enspectr/bar-scan-bt/README.md

# BT adapter for GM67 bar code scanner
Its using ESP32 to implement BLE virtual keyboard for communicating with the host.

This document describes firmware version 1.1.

## Wiring

The following figure shows connections to ESP32C3Zero module used as a controller.

<p align="center">
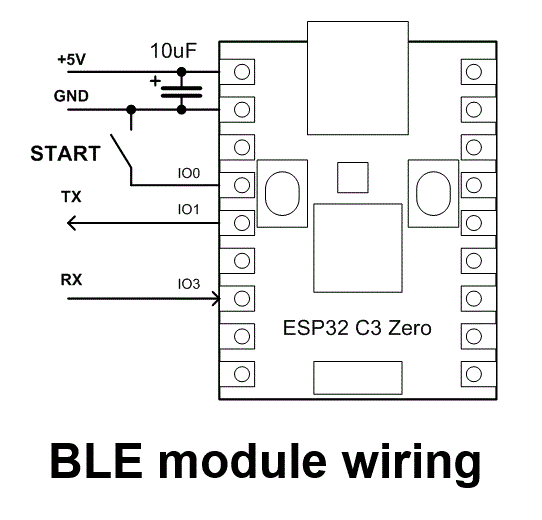
[picture p1: doc/wiring.gif]
  
</p>

## Building

Use Arduino to compile and flash https://github.com/enspectr/bar-scan-bt/blob/main/BarScanBLE/BarScanBLE.ino
To be able to build this code add the following to Arduino Additional board manager URLs:
```
https://raw.githubusercontent.com/espressif/arduino-esp32/gh-pages/package_esp32_index.json
```
Then go to Boards Manager and install **esp32 by Espressif Systems**. The code is tested with version 3.0.7.
Before building the adapter the following libraries should be installed:
1. The NimBLE stack https://github.com/h2zero/NimBLE-Arduino. The simplest way to do it is by using Arduino libraries manager.
2. The virtual keyboard library https://github.com/enspectr/ESP32-BLE-Keyboard. One can either check it out from github to the Arduino libraries folder or download it as [zip-file](https://github.com/enspectr/ESP32-BLE-Keyboard/archive/refs/heads/master.zip) and add it to the project by using menu *Sketch/Include Library/Add .ZIP Library...*
3. Adafruit NeoPixel library (available via Arduino libraries manager).

The following build options are recommended:
* Board: ESP32C3 Dev Module
* USB CDC On Boot: Disabled
* CPU Frequency: 80MHz

## Initial configuration steps

The scanner module factory configuration is continuous scan emulating USB keyboard. So it will not work with ESP32
controller out of the box. There are two control codes that should be scanned once to properly configure GM67 module.

<p align="center">
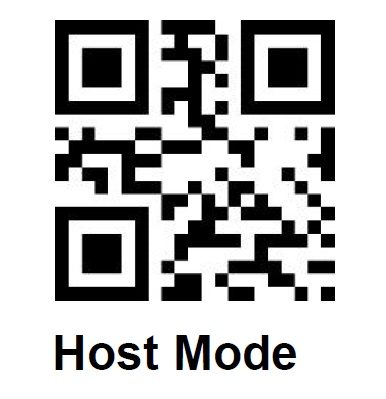
[picture p2: doc/host_mode.jpg]
  
</p>

After switching to host mode the scanner stops continuous scan. Use button on the GM67 module board to scan the following code.

<p align="center">
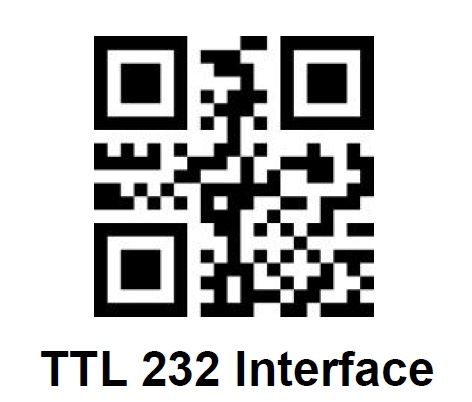
[picture p3: doc/serial_interface.jpg]
  
</p>

## Theory of operation

The adapter presents scanner as BT keyboard with name started with **EScan** followed by a unique suffix made up of 6 hexadecimal digits.
Once scanned, the code will be entered using this virtual keyboard at the place where the input focus is currently located.

Right after powering on the adapter turns on Bluetooth waiting for connection from the host computer. In case no connection is established within 2 minutes it goes into standby mode to save power (if its not [disabled explicitly](#disabling-standby)). In this mode the BT is turned off so the connection to the host computer is impossible. To exit standby mode and turn Bluetooth back on, press the Start button once. If the connection to the host is lost, the adapter goes into standby mode after 10 minutes if the connection is not restored within that time period.

Pressing Start button while the adapter is not connected to the host has no effect unless its pressed twice within 0.7 sec. Ability to start scan with BT not connected may be handy for scanning control codes not intended to be transmitted to the host. Scanning completes either after 5 seconds or earlier if the code was scanned successfully.

### LED indicator functions

The adapter uses on-board RGB LED to indicate its operational status as described in the following table.

| LED Color | Meaning |
|---|---|
| LED off | Standby mode |
| Red | Adapter is starting or resetting |
| Yellow | Adapter is not connected to the host |
| Blue | Adapter is connected to the host |
| Magenta pulse | Scanning started |
| Green pulse | Scanning completed |
| Cyan pulse | Control code scanned |

## Testing

To check if adapter works one may scan the following 'Hello world!' bar code.

<p align="center">
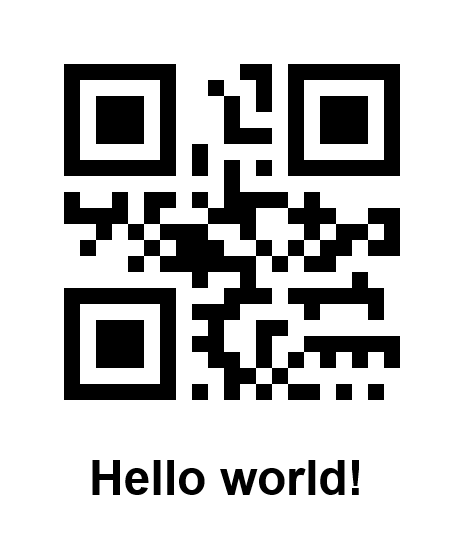
[picture p4: doc/hello_world.png]
  
</p>

Another quick test is to [query adapter version](#finding-adapter-version).

## Advanced configuration

### Code integrity and optional checksums

The bar-code scanner uses virtual keyboard to transfer code scanned to host computer. Unfortunately the low energy Bluetooth is inherently unreliable. So its possible that some symbols may be lost in transit and not be received by the host. If the host does not validate bar-code it has no means to detect code corruption. Another common source of code corruptions is using wrong keyboard layout. Since the scanner transmits the code by simulating a keyboard, using the wrong layout can change the code without the user being aware of it.

The scanner has an option to append checksum to the code scanned so that the host will be able to validate it and detect code corruption in transit. The checksum represents the sum of all ASCII codes in the scanned text by modulo 4096. Its encoded as 2 digit number using *[base64 alphabet](https://en.wikipedia.org/wiki/Base64#Alphabet)* and appended to the end of the scanned text following the ~ separator. The separator allows the host to determine whether the scanned code has a checksum or not, provided that the ~ character is not used in the codes themselves.

For example, the 'Hello world!' code shown above results in printing 'Hello world!~Rd' while scanned with checksums enabled. Indeed the sum of ascii codes is 1117 so the high order digit value is 1117 / 64 = 17 while the low order digit value is 1117 mod 64 = 29. The symbol representing 17 is 'A' + 17 = 'R' while the symbol representing 29 is 'a' + 29 - 26 = 'd'.

To enable checksums one should scan the following control code:

<p align="center">
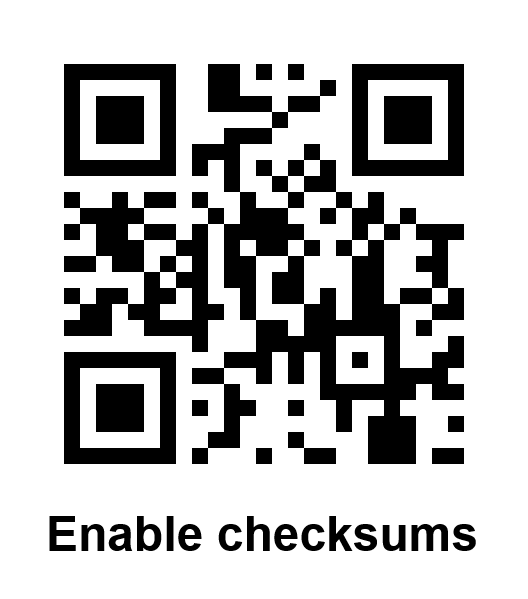
[picture p5: doc/csum_on.png]
  
</p>

Once enabled checksums will always be used even after power cycling. To disable checksums one should scan the following control code:

<p align="center">
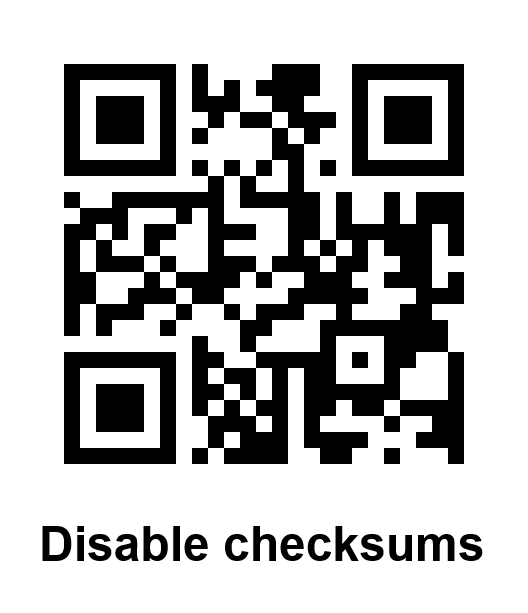
[picture p6: doc/csum_off.png]
  
</p>

### Disabling standby

The standby mode provides more than 2x power saving while the scanner is idle. However, sometimes it needs to be woken up from standby mode, which can be inconvenient. User can disable standby mode by scanning the following control code:

<p align="center">
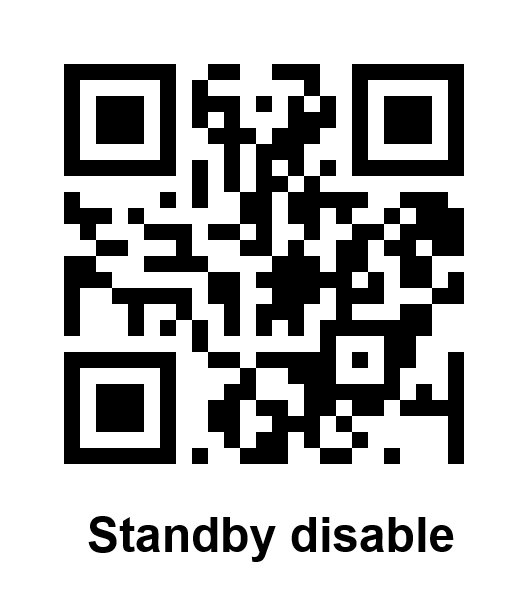
[picture p7: doc/standby_dis.png]
  
</p>

Once disabled standby mode will not be used even after power cycling. To enable it back one should scan the following control code:

<p align="center">
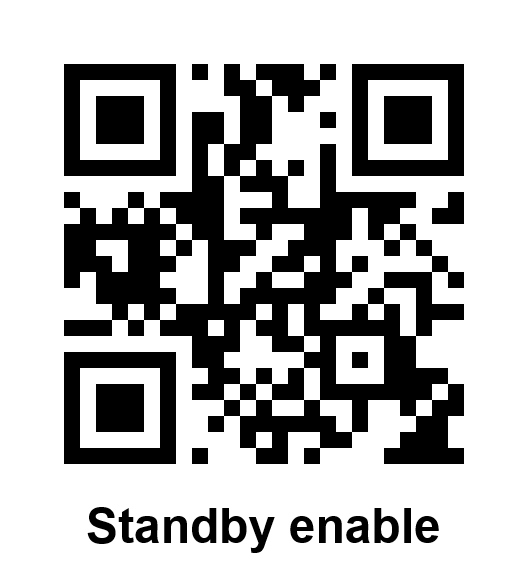
[picture p8: doc/standby_en.png]
  
</p>

## Troubleshooting

If things go wrong one can try the following steps to recover:

### Reset adapter

To reset the adapter, press the Start button and hold it for more than 1.5 seconds. It will restart in standby mode (if its not [disabled explicitly](#disabling-standby)).

### Reconnect adapter to the host

Sometimes scan codes are not being delivered to the host while the connection is established. The root cause of this problem is unknown. Disconnect adapter and connect to it again to recover.

### Reset adapter to factory defaults

This is the method to be used if nothing else have helped. To reset scanner to factory defaults use the following control code and repeat [initial configuration procedure](#initial-configuration-steps).

<p align="center">
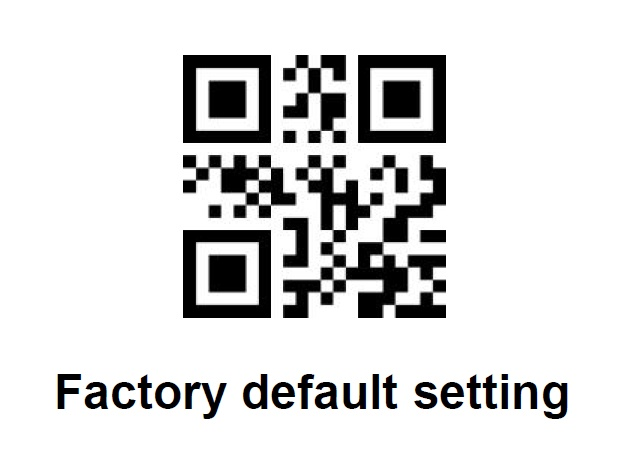
[picture p9: doc/default_settings.jpg]
  
</p>

### Finding adapter version

If some features don't work the first step to investigate the root cause is finding device software version. Below is a special control code that can be scanned to find out the firmware version and build date.

<p align="center">
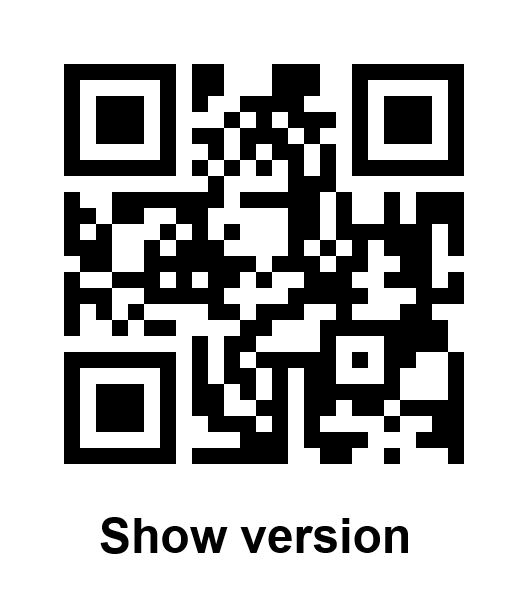
[picture p10: doc/show_version.png]
  
</p>

## Power consumption

The following table summarizes power consumption from 5V source in various operation modes for the GM67 and adapter built with 80MHz CPU frequency setting.

| Operation mode  | BT adapter consumption | GM67 module consumption | Total consumption |
|---|---|---|---|
| Standby | 7mA | 18mA | 25mA |
| Idle | 42mA | 18mA | 60mA |
| Scanning | 42mA | ~200mA | ~242mA |
| Scanning with collimation off | 42mA | ~185mA | ~227mA |

Turning off collimation light beam (red flashing strip) provides marginal power saving in scanning mode. Consult [GM67 User manual](https://github.com/enspectr/bar-scan-bt/blob/main/doc/GM67_Barcode.pdf) to see how to do it.

## Dual mode usage

The adapter has several additional pins that can be used to switch between Bluetooth and serial (or USB HID with additional adapter chip) communication channels. They are shown on the following figure.

<p align="center">
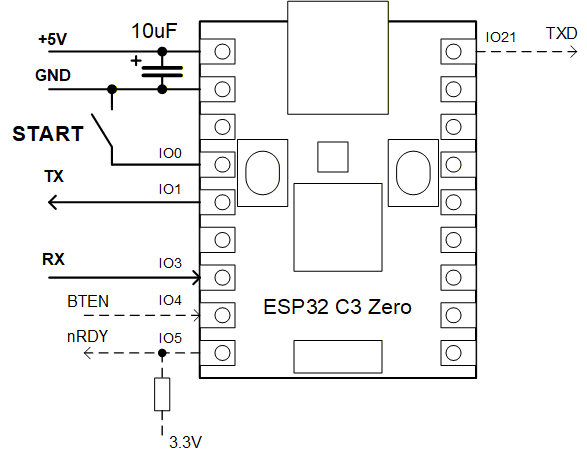
[picture p11: doc/wiring2.gif]
  
</p>

The additional pins definitions are listed in the following table.
| Pin |  Description |
|---|---|
| BTEN | Low level on startup disables Bluetooth and activates serial output (TXD). The pin is pulled up internally so leaving it floating enables Bluetooth operation.  |
| TXD | In case Bluetooth is disabled, the scanned text is output serially to this pin at 9600 baud rate followed by \r symbol (with code 13). |
| nRDY | This pin is set to low level after firmware startup. By pulling it up one can create reset signal (active high) for external circuit receiving data from TXD pin. Such reset signal is necessary since firmware is used to print debug messages to TXD at startup.

For example to create adapter capable of acting as USB HID virtual keyboard one can utilize CH9329 chip wiring TXD to its RXD pin and using nRDY with 10k pull-up resistor as the source of reset signal for CH9329 RST pin.
