enspectr/bar-scan-bt/BarScanBLE/BarScanBLE.ino

/*
 * BT adapter for GM67 barcode scanner
 *
 * (C) 2025-2026 EnSpectr Inc. http://enspectr.com
 * Author: Oleg Volkov <olegv142@gmail.com>
 */

#include <Preferences.h>
#include <BleKeyboard.h>
#include <esp_system.h>
#include <esp_mac.h>
#include <esp_bt.h>
#include <rtc.h>

#define VERSION "1.1"
#define VERSION_INFO "v." VERSION " " __DATE__
#define STRZ_LEN(s) (sizeof(s) / sizeof(*(s)) - 1)

// Comment it out to disable LED
#define RGB_LED 10
#ifdef RGB_LED
#include <Adafruit_NeoPixel.h>
#endif

// Comment it out to keep default power level
#define TX_PW_BOOST ESP_PWR_LVL_P18

#define BTN_PIN  0
#define BTEN_PIN 4
#define BTN_DEBOUNCE_TOUT 50
#define BTN_DBL_PRESS_TOUT 700
#define BTN_LONG_PRESS_TOUT 1500
#define STANDBY_TOUT (600*1000)
#define STANDBY_TOUT_INI (120*1000)

#define BarcodeSerial Serial1
#define TX_PIN 1
#define RX_PIN 3
#define RDY_PIN 5
#define RDY_LVL HIGH
#define BAUD_RATE 9600

#define BARCODE_NOP  0x00
#define AUTO_LIGHT   0x08, 0xC6, 0x04, 0x08, 0x00, 0xF2, 0x02, 0x00, 0xFE, 0x32
#define START_DECODE 0x04, 0xE4, 0x04, 0x00, 0xFF, 0x14
#define START_SCAN5S 0x08, 0xC6, 0x04, 0x08, 0x00, 0xF2, 0xFA, 0x05, 0xFD, 0x35
#define BARCODER_WRITE(cmd) BarcodeSerial.write(cmd, sizeof(cmd))

#define CSUM_SEPARATOR '~'

static unsigned cpu_freq;
static bool     offline_mode;
static bool     in_standby;
static unsigned last_connected;
static unsigned standby_tout = STANDBY_TOUT_INI;

static const byte barcoder_wake_up[] = {BARCODE_NOP};
static const byte barcoder_start[] = {AUTO_LIGHT, BARCODE_NOP, START_DECODE, BARCODE_NOP, START_SCAN5S};

static bool scan_inited, scan_done;
static String scan_buff;

// Command codes:
static const String cmd_chsum_on   ("jMRMf549y172QLpp");
static const String cmd_chsum_off  ("jMRMf549y172QLpq");
static const String cmd_standby_dis("jMRMf549y172QLpr");
static const String cmd_standby_en ("jMRMf549y172QLps");
static const String cmd_print_ver  ("jMRMf549y172QLpv");

// Persistent configuration:
#define CFG_NAMESPACE "BarScanCfg"
static Preferences config;
static bool cfg_csum_on;
static bool cfg_no_standby;

#ifdef RGB_LED
Adafruit_NeoPixel pixels(1, RGB_LED, NEO_GRB + NEO_KHZ800);
#define RGB_(color) pixels.Color(color)
#else
#define RGB_(color) 0
#endif

#define LED_BRIGHTNESS 2
#define LED_BRIGHTNESS_HIGH 64
#define BLACK_()     0, 0, 0
#define RED_(br)     br, 0, 0
#define GREEN_(br)   0, br, 0
#define BLUE_(br)    0, 0, br
#define YELLOW_(br)  br, br/2, 0
#define MAGENTA_(br) br/2, 0, br/2
#define CYAN_(br)    0, br/2, br/2
#define RGB_OFF      RGB_(BLACK_())
#define RGB_RED      RGB_(RED_(LED_BRIGHTNESS))
#define RGB_BLUE     RGB_(BLUE_(LED_BRIGHTNESS))
#define RGB_YELLOW   RGB_(YELLOW_(LED_BRIGHTNESS))
#define RGB_HMAGENTA RGB_(MAGENTA_(LED_BRIGHTNESS_HIGH))
#define RGB_HRED     RGB_(RED_(LED_BRIGHTNESS_HIGH))
#define RGB_HGREEN   RGB_(GREEN_(LED_BRIGHTNESS_HIGH))
#define RGB_HCYAN    RGB_(CYAN_(LED_BRIGHTNESS_HIGH))

// #define DUMP_HEX

#define DEV_NAME "EScan"
static BleKeyboard ble_keyboard(DEV_NAME);

static inline char hex_digit(uint8_t v)
{
    return v < 10 ? '0' + v : 'A' + v - 10;
}

static inline void led_show_color(uint32_t c)
{
#ifdef RGB_LED
	static uint32_t last_color = ~0;
	if (c != last_color) {
		pixels.setPixelColor(0, c);
		pixels.show();
	}
#endif
}

static inline void standby_in(void)
{
	cpu_freq = getCpuFrequencyMhz();
#ifdef RGB_LED
	led_show_color(RGB_OFF);
#endif
	setCpuFrequencyMhz(10);
	in_standby = true;
}

static inline void ble_init_device_name(void)
{
	uint8_t mac[8] = {0};
	if (ESP_OK == esp_efuse_mac_get_default(mac))
	{
		std::string bt_dev_name(DEV_NAME);
		uint8_t sig[] = {(uint8_t)(mac[0] ^ mac[3]), (uint8_t)(mac[1] ^ mac[4]), (uint8_t)(mac[2] ^ mac[5])};
		bt_dev_name += hex_digit(sig[0] >> 4);
		bt_dev_name += hex_digit(sig[0] & 0xf);
		bt_dev_name += hex_digit(sig[1] >> 4);
		bt_dev_name += hex_digit(sig[1] & 0xf);
		bt_dev_name += hex_digit(sig[2] >> 4);
		bt_dev_name += hex_digit(sig[2] & 0xf);
		ble_keyboard.set_device_name(bt_dev_name);
	}
}

static inline void ble_keyboard_init(void)
{
	ble_keyboard.begin();
#ifdef TX_PW_BOOST
	esp_ble_tx_power_set(ESP_BLE_PWR_TYPE_DEFAULT, TX_PW_BOOST);
#endif
}

static inline void standby_out(void)
{
	setCpuFrequencyMhz(cpu_freq);
	ble_keyboard_init();
	in_standby = false;
}

void setup()
{
	config.begin(CFG_NAMESPACE, true);
	cfg_csum_on    = config.getBool("csum_on");
	cfg_no_standby = config.getBool("no_standby");
	config.end();

#ifdef DUMP_HEX
	Serial.begin(BAUD_RATE);
#endif
	BarcodeSerial.begin(BAUD_RATE, SERIAL_8N1, RX_PIN, TX_PIN);
	BarcodeSerial.setTimeout(10);

	pinMode(BTN_PIN,  INPUT_PULLUP);
	pinMode(BTEN_PIN, INPUT_PULLUP);
	pinMode(RDY_PIN, OUTPUT);
	digitalWrite(RDY_PIN, RDY_LVL);

	delay(10);

	offline_mode = !digitalRead(BTEN_PIN);
	if (offline_mode) {
		cfg_no_standby = true;
		Serial0.begin(BAUD_RATE);
	}

#ifdef RGB_LED
	pixels.begin();
	led_show_color(RGB_HRED);
	delay(50);
#endif

	if (cfg_no_standby || esp_rom_get_reset_reason(0) != 5) {
		if (!offline_mode) {
			ble_init_device_name();
			ble_keyboard_init();
		}
	} else
		standby_in();
}

static void reset_self(void)
{
	// Bright red pulse indicates reset
	if (!in_standby)
		led_show_color(RGB_HRED);
	// It turns out that esp_restart() does not really reset hardware so it still consumes
	// higher current than after power on. The deep sleep trick solves this problem.
	esp_sleep_enable_timer_wakeup(10000); // usec
	esp_deep_sleep_start();
}

static void long_press_handler(void)
{
	reset_self();
}

static bool read_btn(void)
{
	static bool btn_pressed;
	static unsigned first_pressed, last_pressed;
	if (!digitalRead(BTN_PIN)) {
		last_pressed = millis();
		if (!btn_pressed) {
			first_pressed = last_pressed;
			btn_pressed = true;
		} else if (last_pressed - first_pressed > BTN_LONG_PRESS_TOUT) {
			long_press_handler();
		}
	} else if (btn_pressed && millis() - last_pressed > BTN_DEBOUNCE_TOUT) {
		btn_pressed = false;
	}
	return btn_pressed;
}

static void save_config(void)
{
	config.begin(CFG_NAMESPACE, false);
	config.putBool("csum_on",    cfg_csum_on);
	config.putBool("no_standby", cfg_no_standby);
	config.end();
}

static inline char b64symbol(uint8_t code)
{
	uint8_t const LETTERS = 'Z' - 'A' + 1;
	if (code < LETTERS)
		return 'A' + code;
	if (code < 2*LETTERS)
		return 'a' + code - LETTERS;
	if (code < 2*LETTERS + 10)
		return '0' + code - 2*LETTERS;
	if (code == 2*LETTERS + 10)
		return '+';
	if (code == 2*LETTERS + 11)
		return '/';
	return 0; // Invalid code
}

static void append_csum(String& s)
{
	unsigned sum = 0;
	for (unsigned i = 0; i < s.length(); ++i)
		sum += (unsigned char)s[i];
	unsigned const b64mask = ((1 << 6) - 1);
	s += CSUM_SEPARATOR;
	s += b64symbol((sum >> 6) & b64mask);
	s += b64symbol(sum & b64mask);
}

static inline void enable_csum(bool on)
{
	if (offline_mode) {
		led_show_color(RGB_HRED);
		delay(30);
		return;
	}
	cfg_csum_on = on;
	// Bright cyan pulse indicates control code reception
	led_show_color(RGB_HCYAN);
	save_config();
	delay(30);
}

static inline void enable_standby(bool en)
{
	if (offline_mode) {
		led_show_color(RGB_HRED);
		delay(30);
		return;
	}
	cfg_no_standby = !en;
	// Bright cyan pulse indicates control code reception
	led_show_color(RGB_HCYAN);
	save_config();
	delay(30);
}

static inline void print_eol(void)
{
	ble_keyboard.press(KEY_RETURN);
	delay(30);
	ble_keyboard.release(KEY_RETURN);
}

static inline void print_version(void)
{
	if (in_standby)
		return;
	// Bright cyan pulse indicates control code reception
	led_show_color(RGB_HCYAN);
	if (offline_mode) {
		Serial0.write(VERSION_INFO, STRZ_LEN(VERSION_INFO));
		Serial0.write('\r');
		return;
	}
	ble_keyboard.print(VERSION_INFO);
	print_eol();
}

static inline void flush_buffer(void)
{
	if (in_standby)
		return;
	// Bright green pulse indicates scanning completion
	led_show_color(RGB_HGREEN);
	if (offline_mode) {
		Serial0.write(scan_buff.c_str(), scan_buff.length());
		Serial0.write('\r');
		return;
	}
	if (cfg_csum_on)
		append_csum(scan_buff);
	ble_keyboard.print(scan_buff);
	print_eol();
}

static void process_barcoder_byte(char c)
{
#ifdef DUMP_HEX
	static char buf[5] = {};
	unsigned const n = snprintf(buf, sizeof(buf)-1, "%02x ", c);
	Serial.write(buf, n);
#else
	static char last_byte;
	if (scan_inited) {
		if (!scan_done) {
			if (c != 0xA && c != 0xD)
				scan_buff += c;
			else {
				/* For some reason while reporting 1D and 2D codes
				 * the scanner uses different line endings.
				 */
				if (scan_buff == cmd_chsum_on)
					enable_csum(true);
				else if (scan_buff == cmd_chsum_off)
					enable_csum(false);
				else if (scan_buff == cmd_standby_dis)
					enable_standby(false);
				else if (scan_buff == cmd_standby_en)
					enable_standby(true);
				else if (scan_buff == cmd_print_ver)
					print_version();
				else
					flush_buffer();
				scan_done = true;
			}
		}
	} else if (last_byte == 0xff && c == 0x28)
		scan_inited = true;
	last_byte = c;
#endif
}

static void barcoder_wait(unsigned msec)
{
	unsigned const start_ts = millis();
	static char buff[256];

	while (millis() - start_ts < msec) {
		unsigned sz = BarcodeSerial.readBytes(buff, sizeof(buff));
		for (unsigned i = 0; i < sz; ++i)
			process_barcoder_byte(buff[i]);
	}
}

static inline void start_scan(void)
{
	scan_inited = scan_done = false;
	scan_buff.clear();
#ifdef DUMP_HEX
	Serial.write('\n');
#endif
	// Bright magenta pulse indicates scanning start
	led_show_color(RGB_HMAGENTA);
	BARCODER_WRITE(barcoder_wake_up);
	barcoder_wait(50);
	BARCODER_WRITE(barcoder_start);
}

void loop()
{
	static bool booted;
	static unsigned boot_ts;
	static bool btn_pressed;
	static unsigned last_press;
	bool const is_connected = !in_standby && !offline_mode && ble_keyboard.isConnected();
	bool const pressed = read_btn();
	unsigned const now = millis();
	unsigned const boot_margin = 200;

	if (!booted) {
		booted = true;
		boot_ts = now;
	}

	if (pressed && !btn_pressed) {
		if (now - boot_ts > boot_margin) {
			if (is_connected || offline_mode || (!in_standby && last_press && now - last_press < BTN_DBL_PRESS_TOUT))
				start_scan();
			else if (in_standby) {
				standby_out();
				last_connected = now;
			}
			last_press = now;
		}
	}
	btn_pressed = pressed;

	if (!in_standby)
	{
		// Restart advertising on disconnect
		if (!is_connected && !offline_mode)
			ble_keyboard.restart_advertising();
		// Indicate connection status
		led_show_color(is_connected ? RGB_BLUE : RGB_YELLOW);
		// Go to standby if not connected for some time
		if (is_connected) {
			last_connected = now;
			standby_tout = STANDBY_TOUT;
		}
		else if (!cfg_no_standby && now - last_connected > standby_tout)
			reset_self();
		barcoder_wait(10);
	} else
		delay(2); // actually it 8x times longer
}
