enspectr/bar-scan-bt/(commit log)

2025-12-22 Test app printing barcode reader output to USB CDC
2025-12-23 Add MAC based suffix to device name
2025-12-23 Wiring figure added
2025-12-23 Raise power level to increase range
2025-12-23 Raise power level for more range
2025-12-24 Raise power for connection only
2025-12-24 Reboot on long press
    [BarScanBLE.ino]
2025-12-24 Use RGB LED to show connection status
2025-12-25 LED function description added to README
2025-12-26 Add captions to wiring image
2025-12-27 The deep sleep trick to reset hardware after soft reset
    [BarScanBLE.ino]
2025-12-27 Power consumption table
2026-01-16 Reset by turning to deep sleep instead of esp_restart
    [BarScanBLE.ino]
2026-01-16 Power on to active state with 2 min standby tout
2026-07-12 Print version info in offline mode
2026-07-12 Notes about CH9329 wiring
2026-08-05 Configure ready pin by macro defines
